deosrc/home-assistant-physical-energy-panel/LayoutDesign.pptx

Energy

Solar

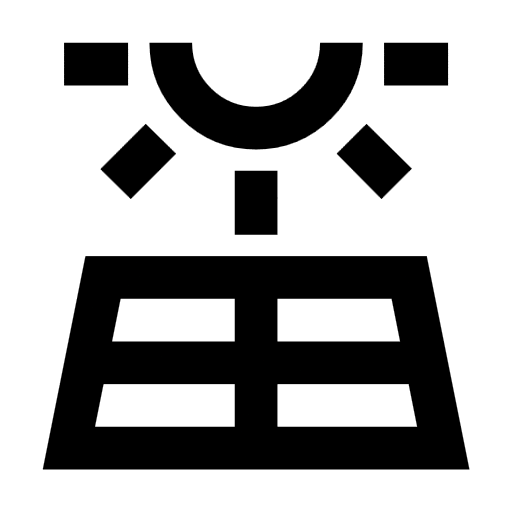
[picture p1: figure]

Grid

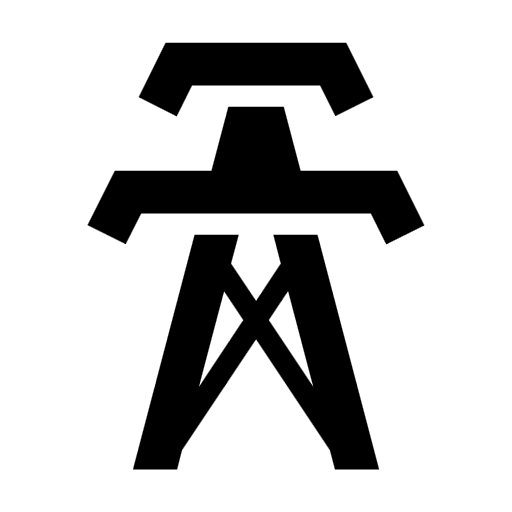
[picture p2: figure]

Home

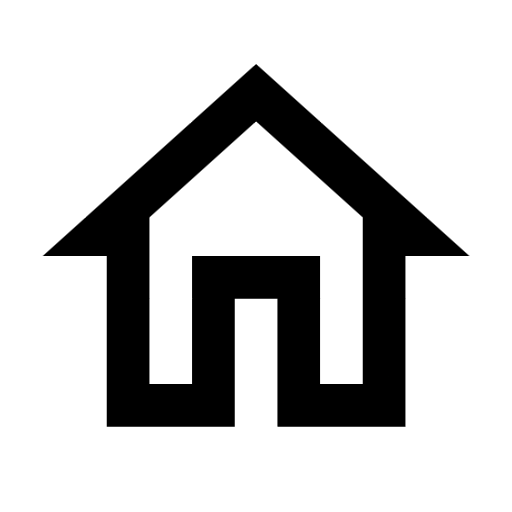
[picture p3: figure]

## Slide 2

Energy

Solar

Home

Grid
