deosrc/home-assistant-physical-energy-panel/3d_printing/7SegmentClockShroud.stl

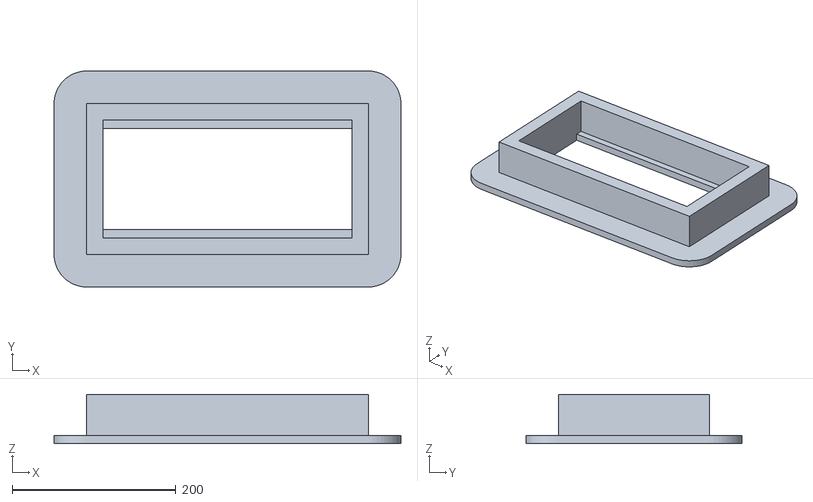
[picture p4: CAD file, 2024-07-23]
3d_printing/7SegmentClockShroud.stl
424.0 x 264.0 x 60.0
