deosrc/home-assistant-physical-energy-panel/3d_printing/LedBarShroud.stl

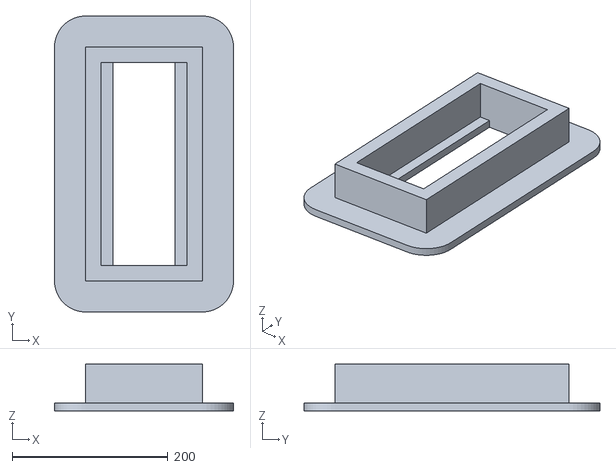
[picture p5: CAD file, 2024-07-23]
3d_printing/LedBarShroud.stl
230.0 x 380.0 x 60.0
