deosrc/home-assistant-physical-energy-panel/3d_printing/Double7SegmentClockShroud.stl

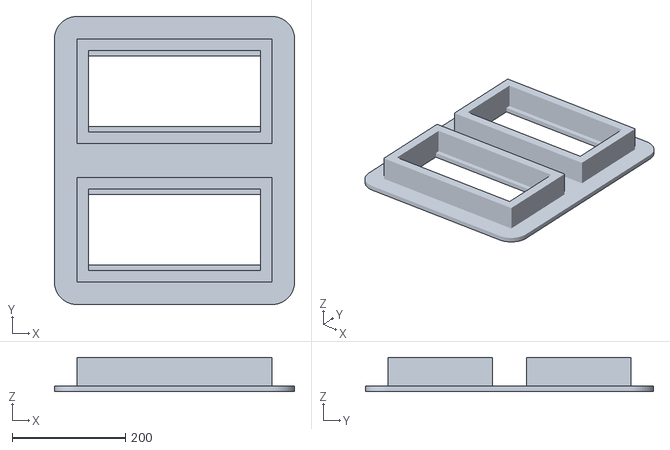
[picture p6: CAD file, 2024-07-23]
3d_printing/Double7SegmentClockShroud.stl
424.0 x 508.0 x 60.0
