deosrc/home-assistant-physical-energy-panel/3d_printing/PrototypeBoardDoubleMountingPlate.stl

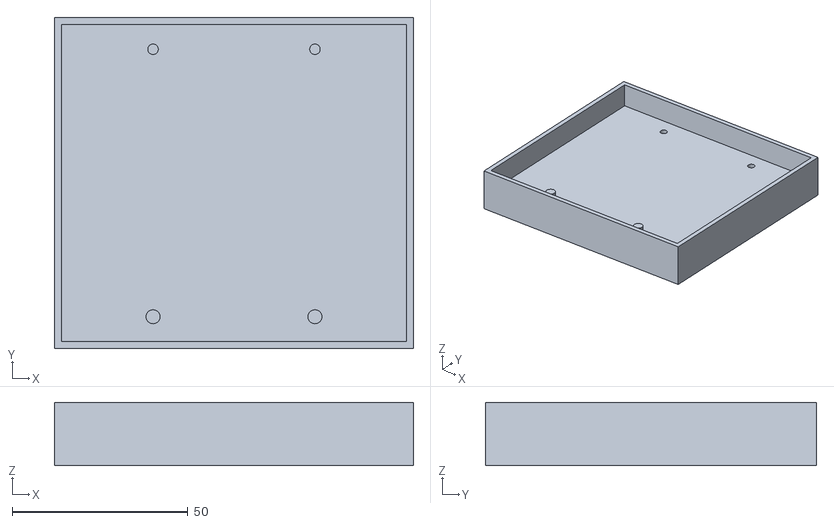
[picture p7: CAD file, 2024-07-23]
3d_printing/PrototypeBoardDoubleMountingPlate.stl
102.0 x 94.0 x 18.0
