deosrc/home-assistant-physical-energy-panel/(list of files, cad)

Other CAD files:
3d_printing/DisplayComponentShrouds.skp
3d_printing/PrototypeBoardDoubleMountingPlate.skp
