deosrc/home-assistant-physical-energy-panel/3d_printing/README.md

# 3D Printing

This folder contains the various 3D models and [Sketchup](https://www.sketchup.com/en) files used for the energy panel.

Some models are created at 10x scale to allow for easier editing in sketchup. Be sure to scale models down to 10% of their size where required.

None of the models should require supports.

## Prototype Board Double Mounting Plate

A simple mounting plate for a double column prototype board to allow for easier mounting and better electrical isolation.

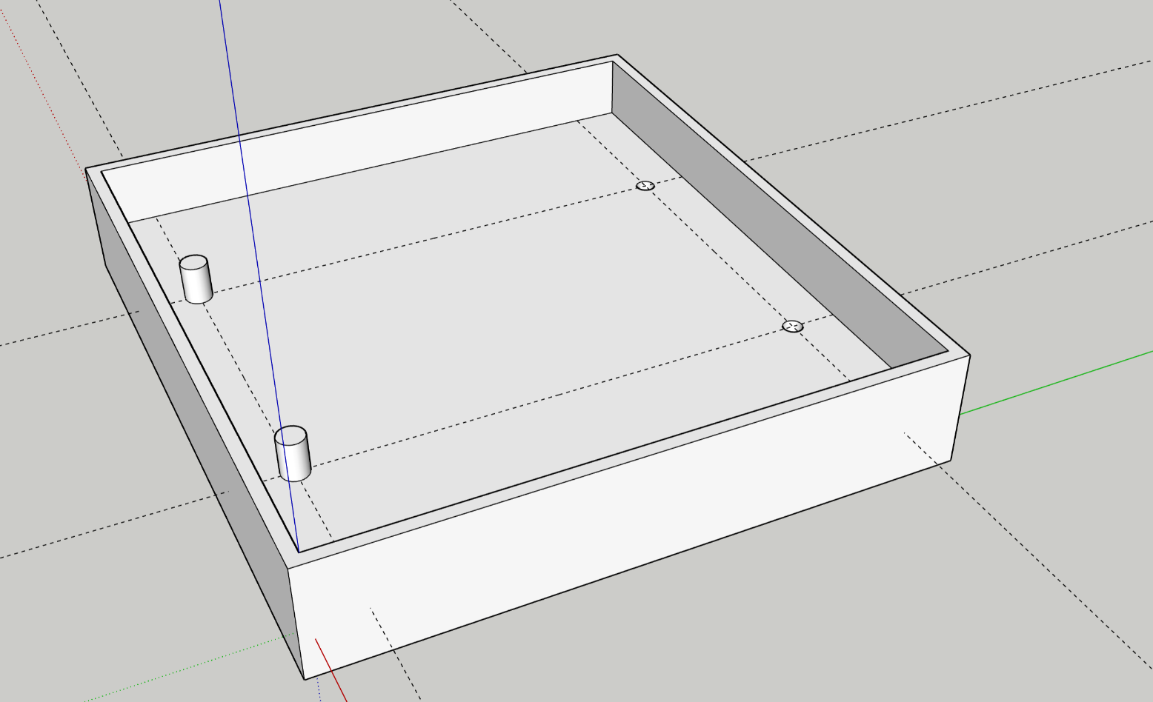
[picture p8: 3d_printing/PrototypeBoardDoubleMountingPlate.png]
Prototype Board Double Mounting Plate


There are 2 stands, and 2 holes for standard motherboard standoffs. The model avoids using 4 standoffs as the screws would be very close or touching multiple connectors potentially creating a short.

> :warning: Be sure to mount the board the correct orientation so that the screws avoid any of the live circuits!

The mounting plate can be glued to the back of the panel.

## Display Component Shrouds/Bezels

In order to neaten the interface between the display components and the mounting, I 3D printed some shrouds/bezels for the displays to be moiunted to. If the holes for the displays are cut neatly, this step may not be required.

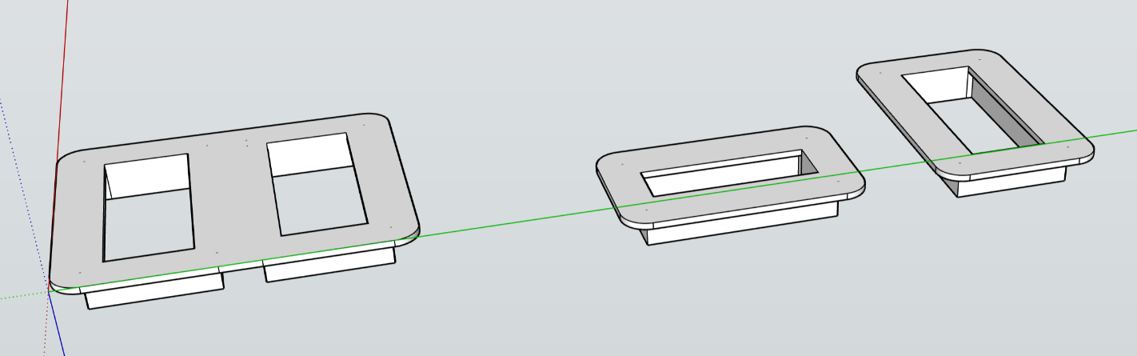
[picture p9: 3d_printing/DisplayComponentShrouds.png]
Display Component Shrouds


There are 3 shrouds:

- **7SegmentClockShroud:** Mounting shroud for a single  7-Segment displays.
- **Double7SegmentClockShroud:** As above but mounts 2 displays. In my design, this is used for grid energy as the displays are so close together that the single shrouds would overlap.
- **LedBarShroud:** Mounting shroud for the 10 LED Bar displays.
