deosrc/home-assistant-physical-energy-panel/(commit log)

2024-07-22 Add materials summary
2024-07-22 Add circuit board instructions
2024-07-22 Add material links
2024-07-23 Add 3D printing files for prototype board mounting plate
    [PrototypeBoardDoubleMountingPlate.skp, PrototypeBoardDoubleMountingPlate.stl]
2024-07-23 Add display shroud 3d printing files
    [7SegmentClockShroud.stl, DisplayComponentShrouds.skp, Double7SegmentClockShroud.stl, LedBarShroud.stl]
2024-07-23 Fix incorrect LED reset point
    [energy_now.yaml]
